mooped/malenki-nano/hardware/malenki-rx/malenki-rx.kicad_pcb

## KiCad design hardware/malenki-rx/malenki-rx.kicad_pcb (2026-01-04)

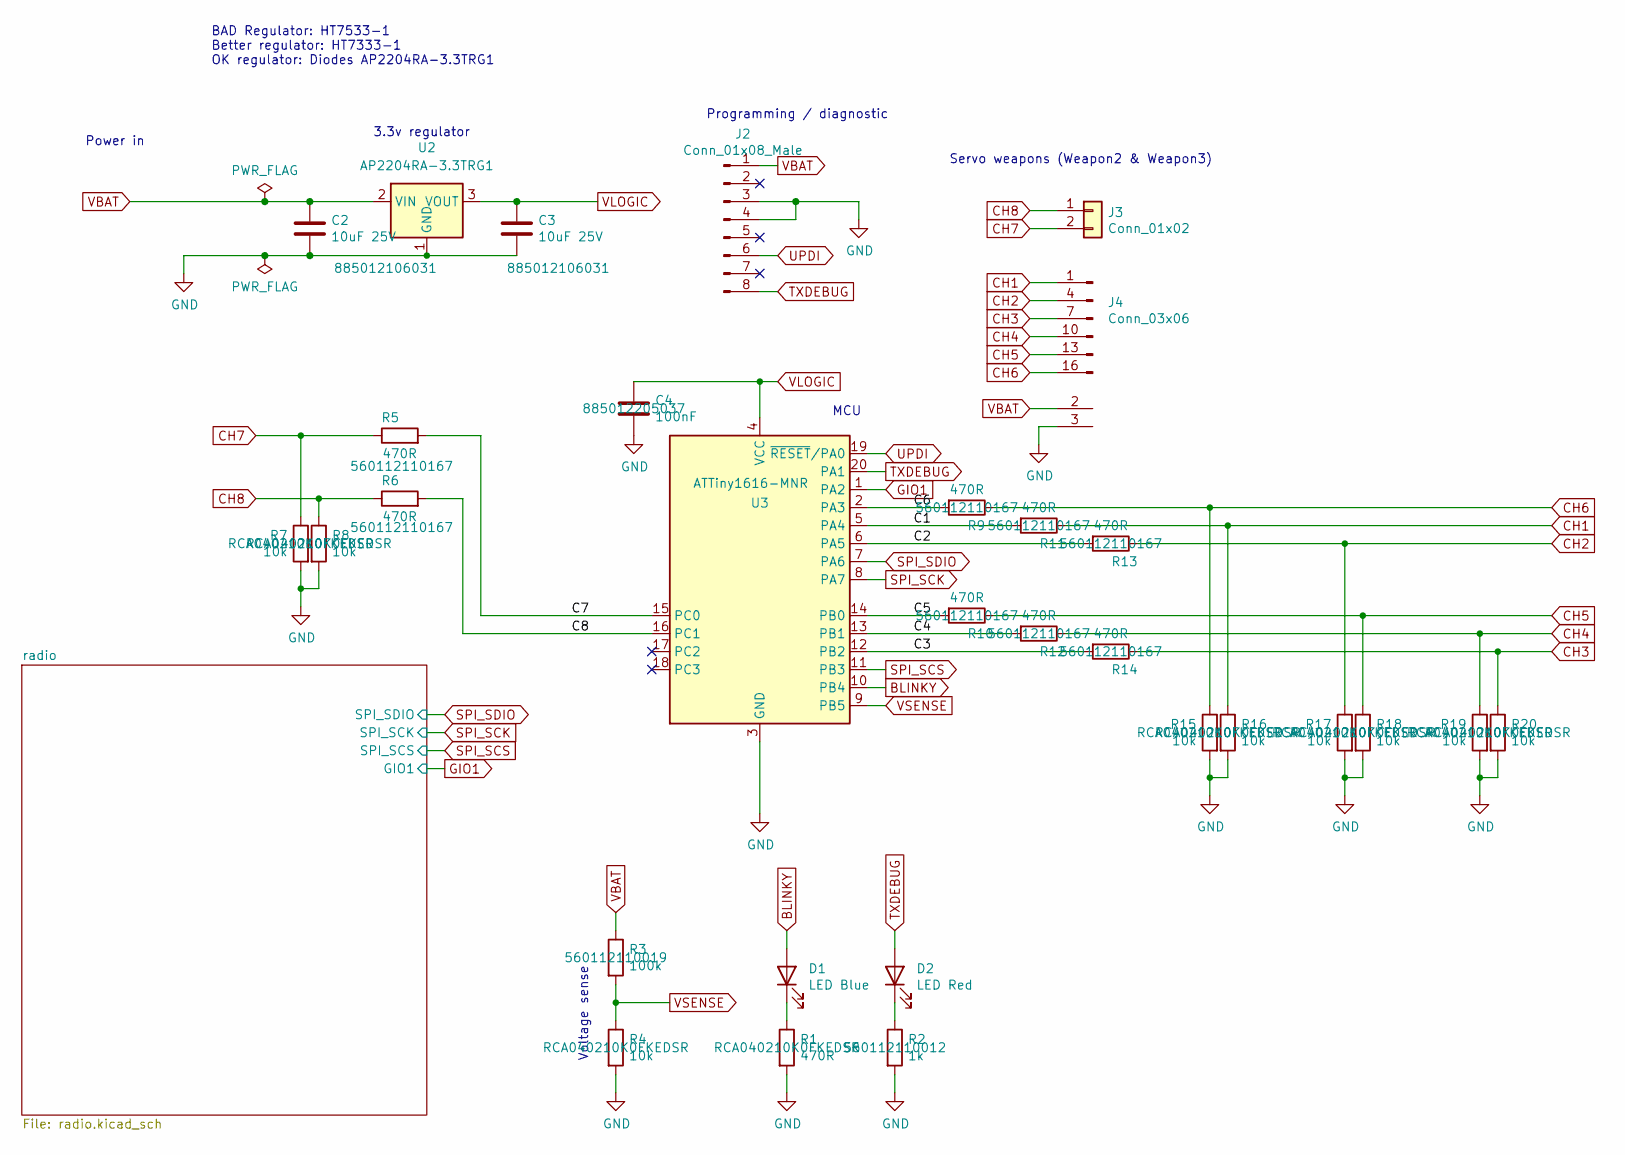
[picture p1: schematic malenki-rx.kicad_sch, Malenki-RX Proto 1]

Parts:
C2, C3: 10uF 25V; C_0603_1608Metric; MPN 885012106031; LCSC C96446
C4: 100nF; C_0402_1005Metric_Pad0.74x0.62mm_HandSolder; Partnum C14663; LCSC C307331
D1: LED Blue; LED_0603_1608Metric; MPN 19-217/BHC-ZL1M2RY/3T; LCSC C72041
D2: LED Red; LED_0603_1608Metric; MPN KT-0603R; LCSC C2286
J2: Conn_01x08_Male; SOIC_clipProgSmall
J3: Conn_01x02; wirepad_2
J4: Conn_03x06; ServoHeader_3x06_P2.54mm_Vertical
R1: 470R; R_0402_1005Metric; MPN RCA040210K0FKEDSR; LCSC C25117
R2: 1k; R_0402_1005Metric; MPN 560112110012; LCSC C11702
R3: 100k; R_0402_1005Metric; MPN 560112110019; LCSC C25741
R4, R7, R8, R15, R16, R17, R18, R19, R20: 10k; R_0402_1005Metric; Partnum C25804; LCSC C25744
R5, R6, R9, R10, R11, R12, R13, R14: 470R; R_0402_1005Metric; MPN 560112110167; LCSC C25117
U2: AP2204RA-3.3TRG1; SOT-89-3; LCSC C151625
U3: ATTiny1616-MNR; VQFN-20-1EP_3x3mm_P0.4mm_EP1.7x1.7mm; MPN ATtiny1616-MNR; LCSC C507118

Connections:
/C1: R11.2, U3.5 (PA4)
/C2: R13.2, U3.6 (PA5)
/C3: R14.2, U3.12 (PB2)
/C4: R12.2, U3.13 (PB1)
/C5: R10.2, U3.14 (PB0)
/C6: R9.2, U3.2 (PA3)
/C7: R5.2, U3.15 (PC0)
/C8: R6.2, U3.16 (PC1)
BLINKY: D1.2 (A), U3.10 (PB4)
CH1: J4.1 (Sig_1), R11.1, R16.1
CH2: J4.4 (Sig_2), R13.1, R17.1
CH3: J4.7 (Sig_3), R14.1, R20.1
CH4: J4.10 (Sig_4), R12.1, R19.1
CH5: J4.13 (Sig_5), R10.1, R18.1
CH6: J4.16 (Sig_6), R9.1, R15.1
CH7: J3.2, R5.1, R7.1
CH8: J3.1, R6.1, R8.1
GIO1: U3.1 (PA2); also elsewhere on the board
GND: C2.2, C3.2, C4.2, J2.3, J2.4, J4.3 (GND_1), J4.6 (GND_2), J4.9 (GND_3), J4.12 (GND_4), J4.15 (GND_5), J4.18 (GND_6), R1.2, R2.2, R4.2, R7.2, R8.2, R15.2, R16.2, R17.2, R18.2, R19.2, R20.2, U2.1 (GND), U3.3 (GND), U3.21 (GND); also elsewhere on the board
unnamed: D1.1 (K), R1.1
unnamed: D2.1 (K), R2.1
SPI_SCK: U3.8 (PA7); also elsewhere on the board
SPI_SCS: U3.11 (PB3); also elsewhere on the board
SPI_SDIO: U3.7 (PA6); also elsewhere on the board
TXDEBUG: D2.2 (A), J2.8, U3.20 (PA1)
UPDI: J2.6, U3.19 (~RESET/PA0)
VBAT: C2.1, J2.1, J4.2 (V_1), J4.5 (V_2), J4.8 (V_3), J4.11 (V_4), J4.14 (V_5), J4.17 (V_6), R3.1, U2.2 (VIN)
VLOGIC: C3.1, C4.1, U2.3 (VOUT), U3.4 (VCC); also elsewhere on the board
VSENSE: R3.2, R4.1, U3.9 (PB5)

Notes on the sheet:
Voltage sense
Power in
Servo weapons (Weapon2 & Weapon3)
Programming / diagnostic
BAD Regulator: HT7533-1 Better regulator: HT7333-1 OK regulator: Diodes AP2204RA-3.3TRG1
MCU
3.3v regulator

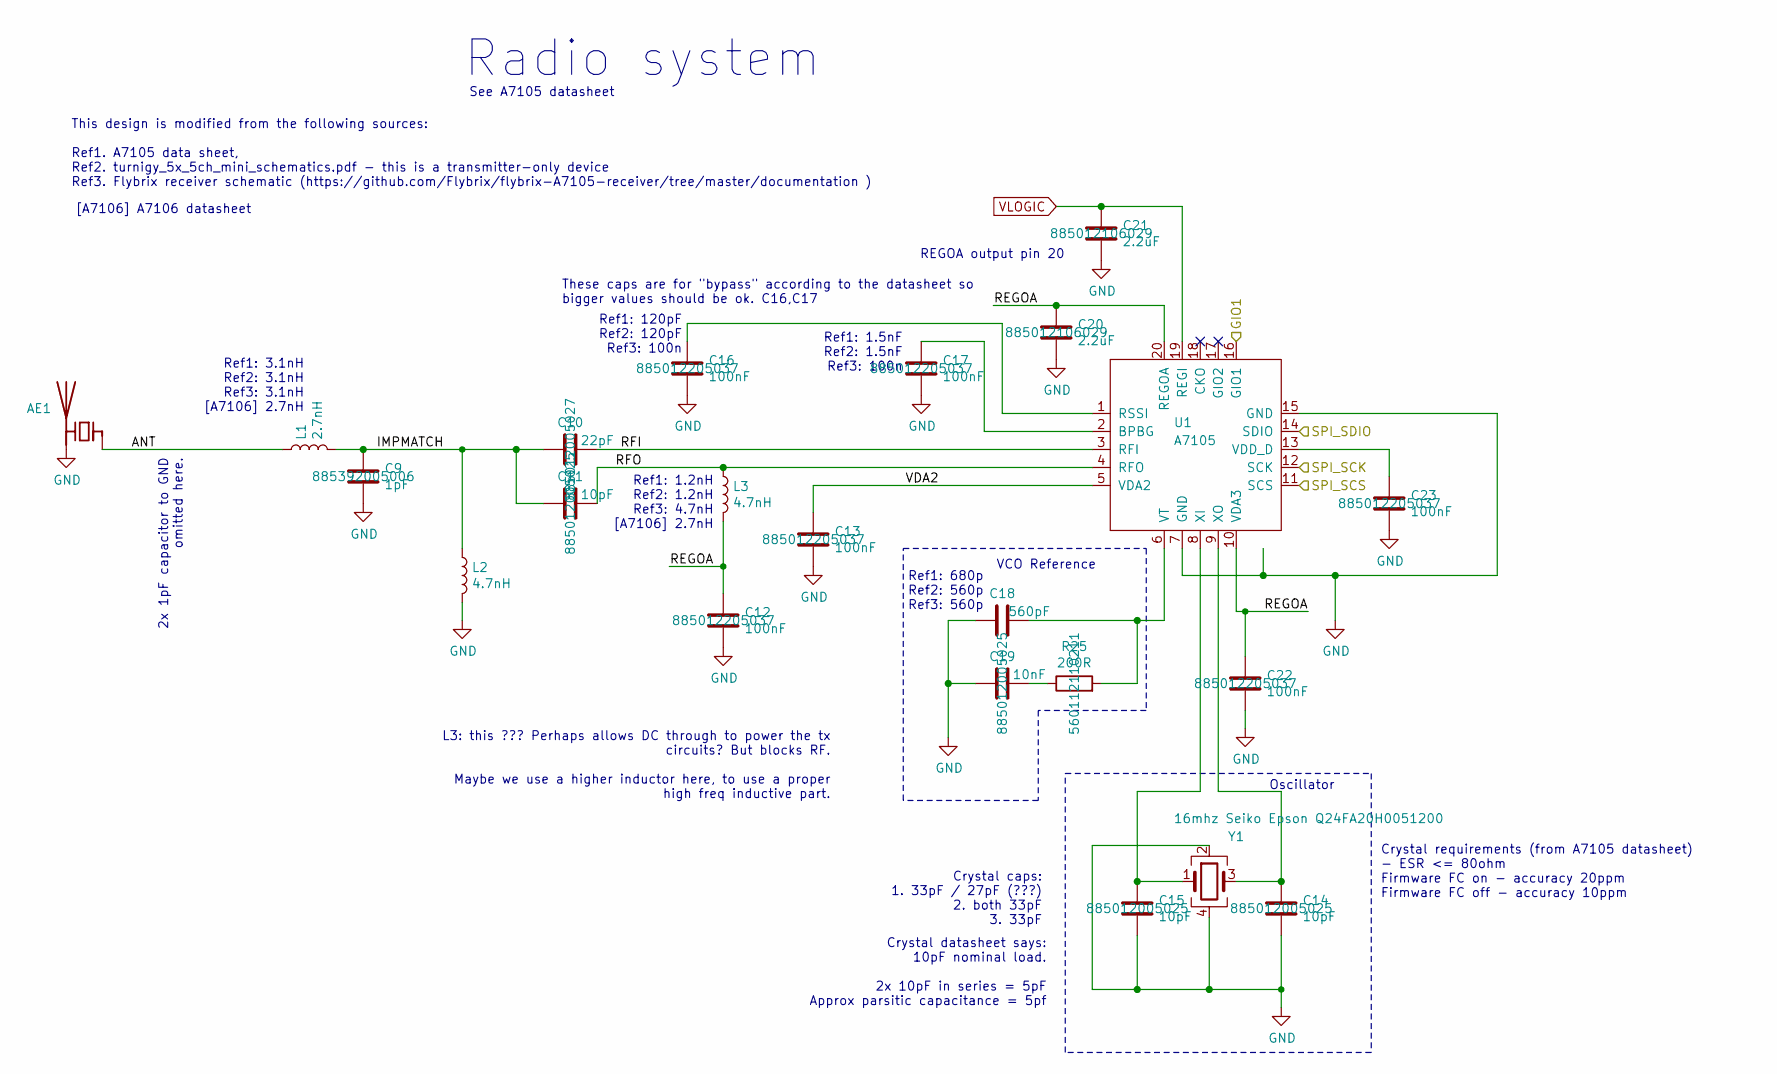
[picture p2: schematic radio.kicad_sch]

Parts:
AE1: malenki_antenna
C9: 1pF; C_0402_1005Metric_Pad0.74x0.62mm_HandSolder; MPN 885392005006; LCSC C1550
C10: 22pF; C_0402_1005Metric_Pad0.74x0.62mm_HandSolder; MPN 885012005027; LCSC C1555
C11, C14, C15: 10pF; C_0402_1005Metric_Pad0.74x0.62mm_HandSolder; MPN 885012005025; LCSC C32949
C12, C13, C16, C17, C22, C23: 100nF; C_0402_1005Metric_Pad0.74x0.62mm_HandSolder; MPN 885012205037; LCSC C307331
C18: 560pF; C_0402_1005Metric_Pad0.74x0.62mm_HandSolder; MPN CL05C561JB5NNNC; LCSC C1539
C19: 10nF; C_0402_1005Metric_Pad0.74x0.62mm_HandSolder; MPN 885012005025; LCSC C15195
C20, C21: 2.2uF; C_0603_1608Metric; MPN 885012106029; LCSC C23630
L1: 2.7nH; L_0402_1005Metric_Pad0.77x0.64mm_HandSolder; LCSC C76791
L2: 4.7nH; L_0402_1005Metric_Pad0.77x0.64mm_HandSolder; MPN LQW15AN4N7D10D; LCSC C341688
L3: 4.7nH; L_0402_1005Metric_Pad0.77x0.64mm_HandSolder; MPN VHF160808H4N7ST; LCSC C341688
R25: 200R; R_0402_1005Metric; MPN 560112110211; LCSC C25087
U1: A7105; a7105-QFN-20; MPN A71X05AQFI/Q; LCSC C126376
Y1: 16mhz Seiko Epson Q24FA20H0051200; Crystal_SMD_2520-4Pin_2.5x2.0mm; MPN Q24FA20H0051200; LCSC C255947

Connections:
/radio/ANT: AE1.1 (FEED), L1.1
/radio/IMPMATCH: C9.1, C10.1, C11.1, L1.2, L2.1
/radio/REGOA: C12.1, C20.1, C22.1, L3.2, U1.10 (VDA3), U1.20 (REGOA)
/radio/RFI: C10.2, U1.3 (RFI)
/radio/RFO: C11.2, L3.1, U1.4 (RFO)
/radio/VDA2: C13.1, U1.5 (VDA2)
GIO1: U1.16 (GIO1); also elsewhere on the board
GND: AE1.2 (PCB_Trace), C9.2, C12.2, C13.2, C14.2, C15.2, C16.2, C17.2, C18.1, C19.2, C20.2, C21.2, C22.2, C23.2, L2.2, U1.7 (GND), U1.15 (GND), U1.21 (GND), Y1.2, Y1.4; also elsewhere on the board
unnamed: C19.1, R25.1
unnamed: C17.1, U1.2 (BPBG)
unnamed: C16.1, U1.1 (RSSI)
unnamed: C23.1, U1.13 (VDD_D)
unnamed: C18.2, R25.2, U1.6 (VT)
unnamed: C15.1, U1.8 (XI), Y1.1
unnamed: C14.1, U1.9 (XO), Y1.3
SPI_SCK: U1.12 (SCK); also elsewhere on the board
SPI_SCS: U1.11 (SCS); also elsewhere on the board
SPI_SDIO: U1.14 (SDIO); also elsewhere on the board
VLOGIC: C21.1, U1.19 (REGI); also elsewhere on the board

Notes on the sheet:
REGOA output pin 20
Radio system
Ref1: 3.1nH Ref2: 3.1nH Ref3: 3.1nH [A7106] 2.7nH
See A7105 datasheet
Ref1: 120pF Ref2: 120pF Ref3: 100n
Crystal datasheet says: 10pF nominal load. 2x 10pF in series = 5pF Approx parsitic capacitance = 5pf
Oscillator
Ref1: 1.2nH Ref2: 1.2nH Ref3: 4.7nH [A7106] 2.7nH
L3: this ??? Perhaps allows DC through to power the tx circuits? But blocks RF. Maybe we use a higher inductor here, to use a proper high freq inductive part.
Crystal requirements (from A7105 datasheet) - ESR <= 80ohm Firmware FC on - accuracy 20ppm Firmware FC off - accuracy 10ppm
[A7106] A7106 datasheet
These caps are for "bypass" according to the datasheet so bigger values should be ok. C16,C17
Ref1: 680p Ref2: 560p Ref3: 560p
VCO Reference
2x 1pF capacitor to GND omitted here.
This design is modified from the following sources: Ref1. A7105 data sheet, Ref2. turnigy_5x_5ch_mini_schematics.pdf - this is a transmitter-only device Ref3. Flybrix receiver schematic (https://github.com/Flybrix/flybrix-A7105-receiver/tree/master/documentation )
Crystal caps: 1. 33pF / 27pF (???) 2. both 33pF 3. 33pF
Ref1: 1.5nF Ref2: 1.5nF Ref3: 100n

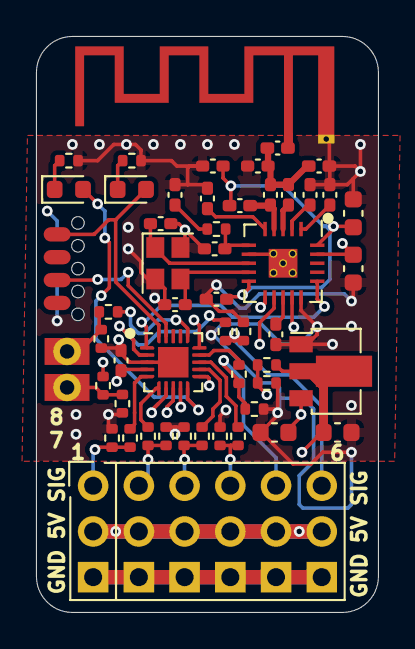
[picture p3: board malenki-rx.kicad_pcb from above]

Board: 4 copper layers, 19.0 x 32.0 mm, 52 parts (1 on the bottom side), 42 nets.
