mooped/malenki-nano/firmware/nano2/main.c

#include <avr/io.h>
#include <avr/interrupt.h>
#include <avr/wdt.h>

#define F_CPU 10000000 /* 10MHz / prescale=2 */
#include <util/delay.h>

#include <string.h>
#include <stdarg.h>
#include <stdio.h>
#include <stdbool.h>

#include "diag.h"
#include "a7105_spi.h"
#include "radio.h"
#include "state.h"
#include "motors.h"
#include "nvconfig.h"
#include "mixing.h"
#include "weapons.h"
#include "vsense.h"
#include "sticks.h"

volatile master_state_t master_state;
extern const char * const end_marker;

static void init_clock()
{
    // This is where we change the cpu clock if required.
    uint8_t val = CLKCTRL_PDIV_2X_gc | 0x1;  // 0x1 = PEN enable prescaler.
    _PROTECTED_WRITE(CLKCTRL.MCLKCTRLB, val);
    _delay_ms(10);
}

static void init_serial()
{
    // UART0- need to use "alternate" pins 
    // This puts TxD and RxD on PA1 and PA2
    PORTMUX.CTRLB = PORTMUX_USART0_ALTERNATE_gc; 
    // Diagnostic uart output       
    // TxD pin PA1 is used for diag, should be an output
    // And set it initially high
    PORTA.OUTSET = 1 << 1;
    PORTA.DIRSET = 1 << 1;
    
    uint32_t want_baud_hz = 230400; // Baud rate (was 115200)
    uint32_t clk_per_hz = F_CPU; // CLK_PER after prescaler in hz
    uint16_t baud_param = (64 * clk_per_hz) / (16 * want_baud_hz);
    USART0.BAUD = baud_param;
    USART0.CTRLB = 
        USART_TXEN_bm | USART_RXEN_bm; // Start Transmitter and receiver
    // Enable interrupts from the usart rx
    // USART0.CTRLA |= USART_RXCIE_bm;
}

static void init_timer()
{
    // This uses TCD0 for timer interrupts.
    // weapons.c sets TCD0 to overflow every 20ms,
    
    TCD0.INTCTRL = TCD_OVF_bm;

    master_state.tickcount = 0;
}

ISR(TCD0_OVF_vect)
{
    // TCD0 will overflow every 20 ms
    master_state.tickcount += 2;
    TCD0.INTFLAGS |= TCD_OVF_bm; //clear the interrupt flag
}

void trigger_reset()
{
    // Pull the reset line.
    cli();
    while (1) {
        _PROTECTED_WRITE(RSTCTRL.SWRR, 1);
    }
}

uint32_t get_tickcount()
{
    uint32_t tc;
    cli(); // disable irq
    tc = master_state.tickcount;
    sei(); // enable irq
    return tc;
}

static void uninit_everything()
{
    USART0.CTRLB = 0; //disable rx and tx
    // Set all ports as inputs.
    PORTA.DIR = 0 ;
    PORTB.DIR = 0 ;
    PORTC.DIR = 0 ;
    // Disable all the timers, so that nothing can keep
    // going automatically.
    TCA0.SPLIT.CTRLA = 0;
    TCB0.CTRLA = 0;
    TCD0.CTRLA = 0;
}

void epic_fail(const char * reason)
{
    diag_puts(reason);
    diag_puts("\r\nFAIL FAIL FAIL!\r\n\n\n");
    _delay_ms(10); // allow transmission of message
    cli(); // No interrupts now please.
    uninit_everything();
    // This gives UPDI a chance to come in and erase or 
    // reflash the device, which we might not be able to do
    // if there is an electrical fault with some pins held.
    _delay_ms(1000); 
    trigger_reset(); // Reset the whole device to try again.
}

/*
 * Device id is at SIGROW.DEVICEID0, 1, 2
 * attiny1614 =  0x1e 0x94 0x22
 * attiny1617 =  0x1e 0x94 0x20
 * attiny3217 =  0x1e 0x95 0x22
 */
 
static void show_device_info()
{
#ifdef ENABLE_DIAG
    diag_println("device id=%02x %02x %02x",
        (int) SIGROW.DEVICEID0,
        (int) SIGROW.DEVICEID1,
        (int) SIGROW.DEVICEID2);
    diag_print("serial number: ");
    uint8_t * serialnum = (uint8_t *) & (SIGROW.SERNUM0);
    for (uint8_t i=0; i<10; i++) {
        diag_print("%02x ", (int) serialnum[i]);
    }
    diag_puts("\r\n");
    char buf[20];
    strncpy(buf, (char *) serialnum, 10);
    buf[10] = '\0';
    diag_println("serial number (ascii) is:%s", buf);
#endif // ENABLE_DIAG
}

static void watchdog_stop()
{
    // Deactivates watchdog
    _PROTECTED_WRITE(WDT.CTRLA, 0);    
}

void shutdown_system()
{
    cli();
    diag_println("### Shutting down ###");
    diag_puts("\r\n");
    radio_shutdown();
    watchdog_stop();
    diag_println("Radio is shut down. Goodnight.");
    // Set all ports to inputs.
    // This saves a little current powering the leds etc.
    // Also, if the motors are running, they will stop.
    uninit_everything();
    
    // The end.
    for (;;) { }
}

/*
 * Watchdog - this will reset the MCU if either
 * a) The main loop stops spinning or
 * b) Radio interrupts stop for some reason
 * 
 * We do this by using a global flag which is set in the radio interrupt,
 * and checked in the main loop.
 * 
 * If we kicked the dog directly in the radio interrupt, then it might
 * not reset if the main loop hangs.
 */

static void watchdog_early_init()
{
    // Tell the developers that the dog was triggered.
    if (RSTCTRL.RSTFR & RSTCTRL_WDRF_bm) {
        diag_puts("wdog fired\r\n");
    }
    // reset the flag or it stays across other types of reset.
    RSTCTRL.RSTFR = RSTCTRL_WDRF_bm; 
}

static void watchdog_init()
{
    // WDT_PERIOD_256CLK_gc = (0x06<<0), approx 0.25s
    uint8_t wdt_ctrla = WDT_PERIOD_256CLK_gc; 
    _PROTECTED_WRITE(WDT.CTRLA, wdt_ctrla);    
}

static void watchdog_loop()
{
    // Kick the dog to stop it from resetting, if the radio
    // interrupts are working ok.
    if (master_state.radio_interrupt_ok) {
        wdt_reset();
        master_state.radio_interrupt_ok = 0;
    }
}
 
int main(void)
{
    init_clock();
    init_serial();
    // Write the greeting message as soon as possible.
    diag_puts(
#if PRODUCT_IS_SCARAB
    "\r\nScarab ESC+RX 2024"
#elif PRODUCT_IS_RX
    "\r\nReceiver"
#else
    "\r\nMalenki-Nano 2023B"
    #ifdef PRODUCT_IS_PLUS
            " HV (High Voltage)"
    #endif    
#endif
        "\r\n"
    );
    watchdog_early_init();
    init_timer();
    sei(); // interrupts on
    weapons_init();
    show_device_info();
    // test_get_micros();
    spi_init();
    motors_init();
    mixing_init(); // reset default config
    nvconfig_load(); // load config from eeprom, if it is setup.
    vsense_init();
    sticks_init();
    // Initialise the radio last.
    radio_init();
    watchdog_init();
    
    while(1) {
        // Main loop
        radio_loop();
        vsense_loop();
        sticks_loop();
        watchdog_loop();
        motors_loop();
    }
}
