mooped/malenki-nano/(commit log)

2026-01-04 Malenki-rx with 8 PWM outputs. Prototype 1 as ordered from Aisler.
    [malen.csv, malenki-rx.kicad_pcb, malenki-rx.kicad_sch, motor_driver.kicad_sch, radio.kicad_sch]
2026-01-04 Cleanup old BOM Add a very important crab logo
    [malen.csv, malenki-rx.kicad_pcb]
2026-01-04 Fix the crab
    [malenki-rx.kicad_pcb]
2026-01-22 Add interactive HTML BOM
2026-01-25 Add rx board with attiny1616 Makefile Add avr libc paths to common.mk
2026-01-26 WIP: TCA0 split PWM with solid highs and lows
2026-02-01 6 channel of PWM using TCA0 in 16 bit mode via CMP0 interrupt TODO: implement downtime for 20ms period TODO: investigate radio timings and try to sync pulse outputs to end when we're not expecting in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
2026-02-02 Rework interrupt driven PWM output slightly (still not satisfactory)
    [motors_pwm.c]
2026-02-03 Tweak timings for as close as possible to 50hz cycles Set TCA0 CMP interrupt as LVL1 priority to avoid timing jitter Reset counter in TCA0 OVF interrupt to remove jitter at the start of the pulse and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
    [motors_pwm.c]
